probstj03/ARC-Play/hardware/3D-Druck/tft-lcd-2-4-inch-ili9341-touch-320x240-1.snapshot.15/2.jpg

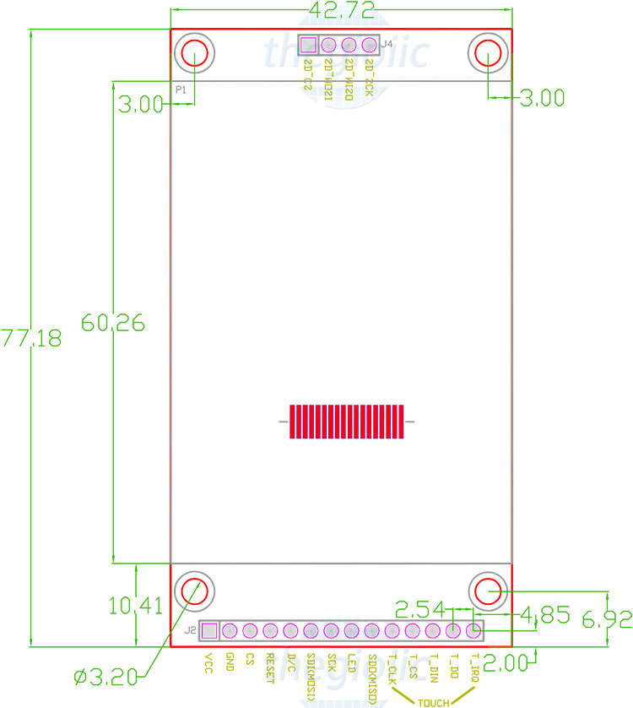
hardware/3D-Druck/tft-lcd-2-4-inch-ili9341-touch-320x240-1.snapshot.15/2.jpg
