probstj03/ARC-Play/hardware/3D-Druck/ARC_Play.FCStd

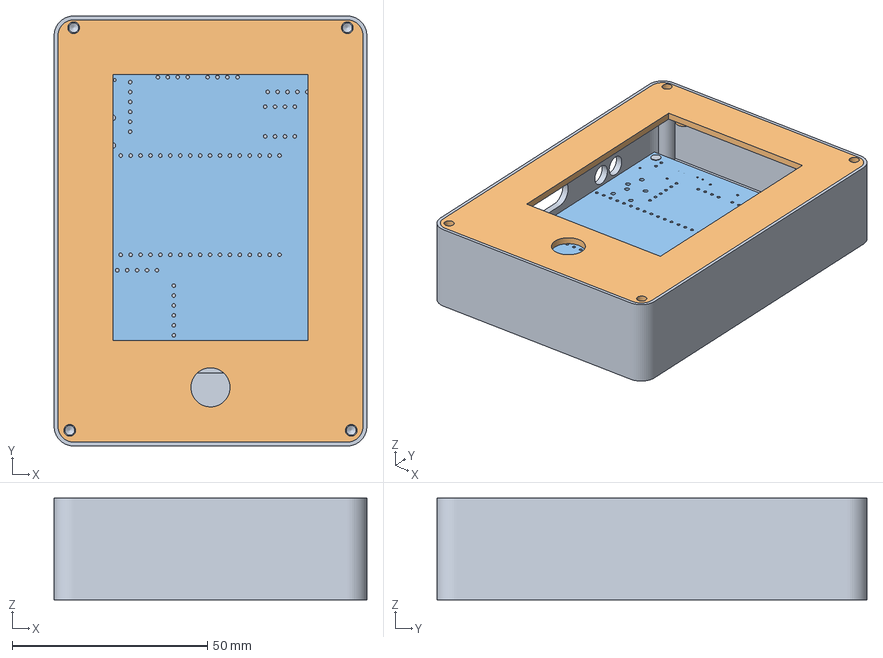
[picture p8: CAD file, 2026-10-11]
hardware/3D-Druck/ARC_Play.FCStd
80.0 x 110.0 x 26.0 mm
Korpus
Deckel
ARC_AP
