probstj03/ARC-Play/hardware/3D-Druck/tft-lcd-2-4-inch-ili9341-touch-320x240-1.snapshot.15/TFT LCD 2.4 inch ILI9341 touch.step

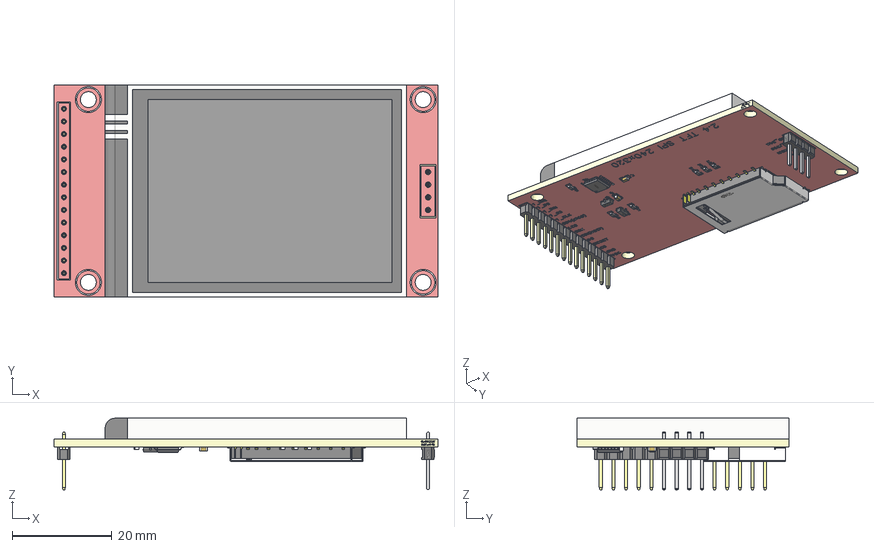
[picture p9: CAD file, 2026-10-11]
hardware/3D-Druck/tft-lcd-2-4-inch-ili9341-touch-320x240-1.snapshot.15/TFT LCD 2.4 inch ILI9341 touch.step
77.2 x 42.7 x 14.4 mm
Board~HwOR
TopSilkscreen~HwOR
BottomSilkscreen~HwOR
R0603~R0603~HwOR x 6
C0603~C0603_L1.6-W0.8-H0.8~HwOR x 2
HDR-TH_4P-P2.54-V-M~HDR-TH_4P-P2.54-M-LI-1X4P~HwOR
CONN-TH_PZ254V-11-14P~CONN-TH_PZ254V-11-14P~HwOR
SOT-23-3_L2.9-W1.3-P1.90-LS2.4-BR~SOT-23-3P_L2.9-W1.3-H1.0-LS2.4-P0.9 5~HwOR x 2
SD-CARD-SMD_SD-CARD-11P~SD-CARD-SMD_SD-CARD-11P~HwOR
TSSOP-16_L5.0-W4.4-P0.65-LS6.4-BL~TSSOP-16_L5.0-W4.4-H1.0-LS6.4-P0.65 ~HwOR
text
