probstj03/ARC-Play/hardware/ARC_Playback.1/LIB_ESP32-S3-DevKitC-1-N32R16V/ESP32-S3-DevKitC-1-N32R16V/3D/ESP32-S3-DevKitC-1-N32R16V.stp

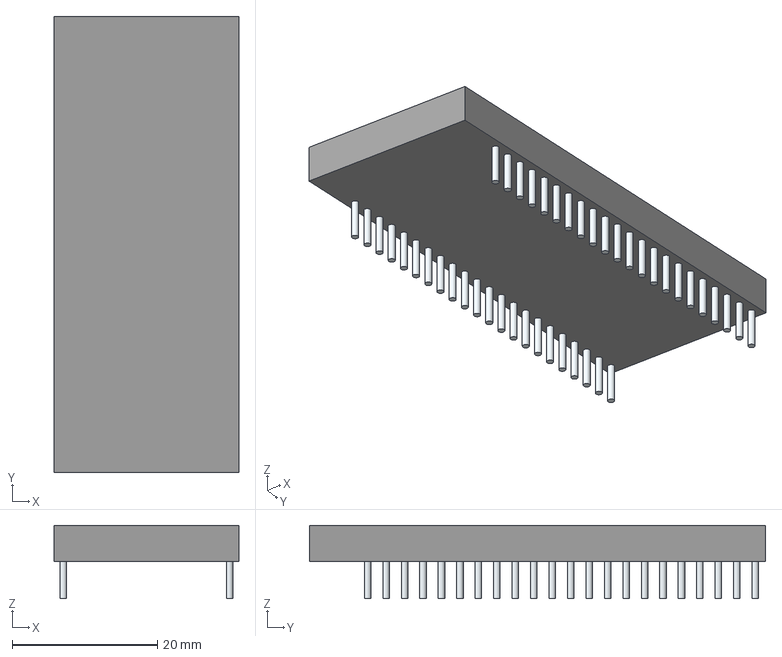
[picture p10: CAD file, 2026-10-11]
hardware/ARC_Playback.1/LIB_ESP32-S3-DevKitC-1-N32R16V/ESP32-S3-DevKitC-1-N32R16V/3D/ESP32-S3-DevKitC-1-N32R16V.stp
25.4 x 62.7 x 10.1 mm
Leads
