probstj03/ARC-Play/hardware/3D-Druck/ARC_Play_Deckel.stl

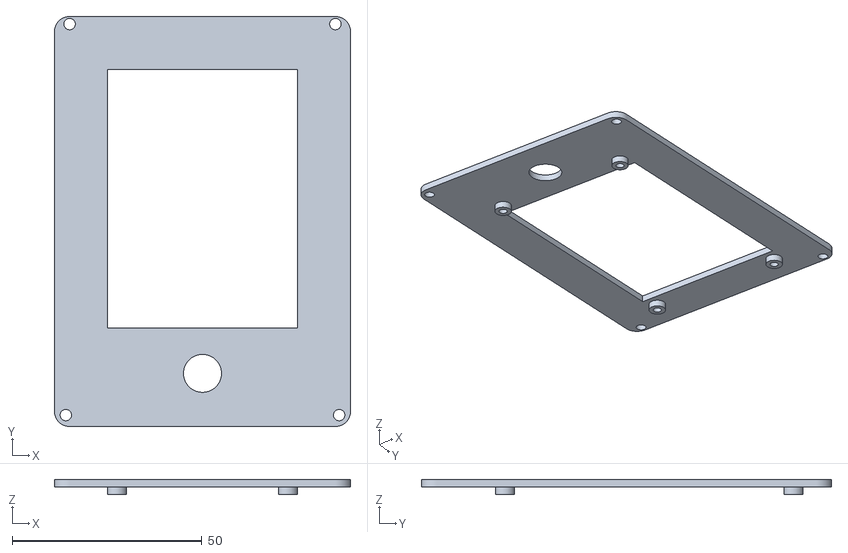
[picture p11: CAD file, 2026-10-11]
hardware/3D-Druck/ARC_Play_Deckel.stl
78.0 x 108.0 x 4.00
