probstj03/ARC-Play/hardware/3D-Druck/ARC_Play_Korpus.stl

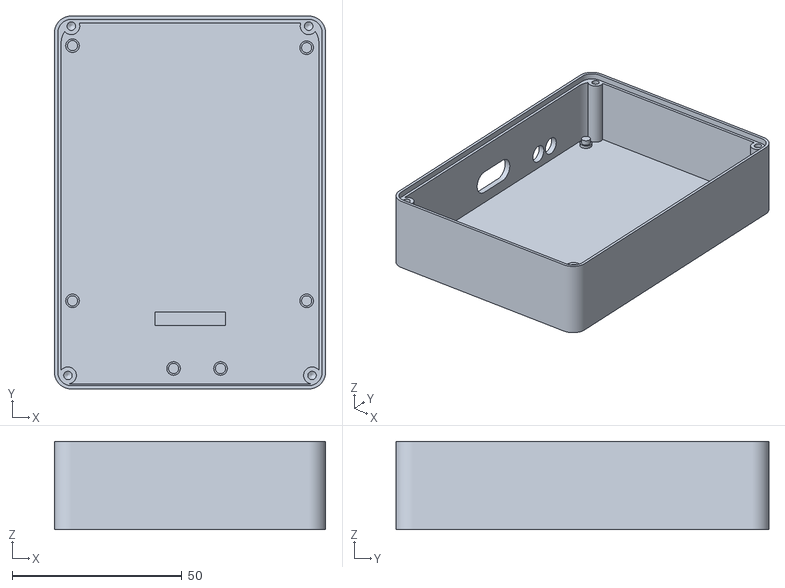
[picture p12: CAD file, 2026-10-11]
hardware/3D-Druck/ARC_Play_Korpus.stl
80.0 x 110.0 x 26.0
