probstj03/ARC-Play/(list of files, cad)

Other CAD files:
hardware/ARC_Playback.1/LIB_ESP32-S3-DevKitC-1-N32R16V/ESP32-S3-DevKitC-1-N32R16V/Allegro/esp32s3devkitc1n32r16v.psm
hardware/ARC_Playback.1/LIB_ESP32-S3-DevKitC-1-N32R16V/ESP32-S3-DevKitC-1-N32R16V/DEHDL/esp32_s3_devkitc_1_n32r16v/chips/chips.prt
