probstj03/ARC-Play/hardware/ARC_Playback.1/ARC_AP_Druck.pdf

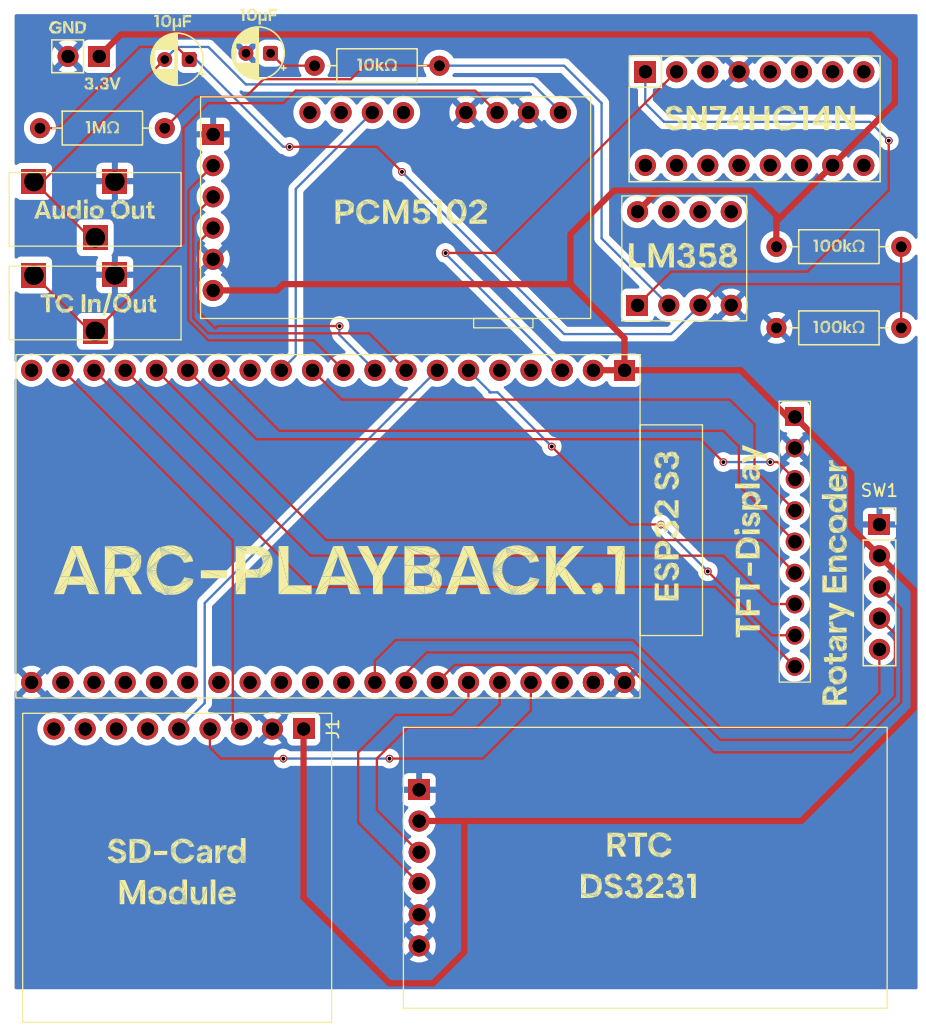
[picture p13: page 1]
