probstj03/ARC-Play/(list of files, drawings)

Other design files:
hardware/ARC_Playback.1/LIB_ESP32-S3-DevKitC-1-N32R16V/ESP32-S3-DevKitC-1-N32R16V/Altium/ESP32-S3-DevKitC-1-N32R16V.SchLib
hardware/ARC_Playback.1/LIB_ESP32-S3-DevKitC-1-N32R16V/ESP32-S3-DevKitC-1-N32R16V/Altium/ESP32S3DevKitC1N32R16V.PcbLib
