probstj03/ARC-Play/hardware/ARC_Playback.1/ARC_AP.kicad_pcb

## KiCad design hardware/ARC_Playback.1/ARC_AP.kicad_pcb (2026-10-11)

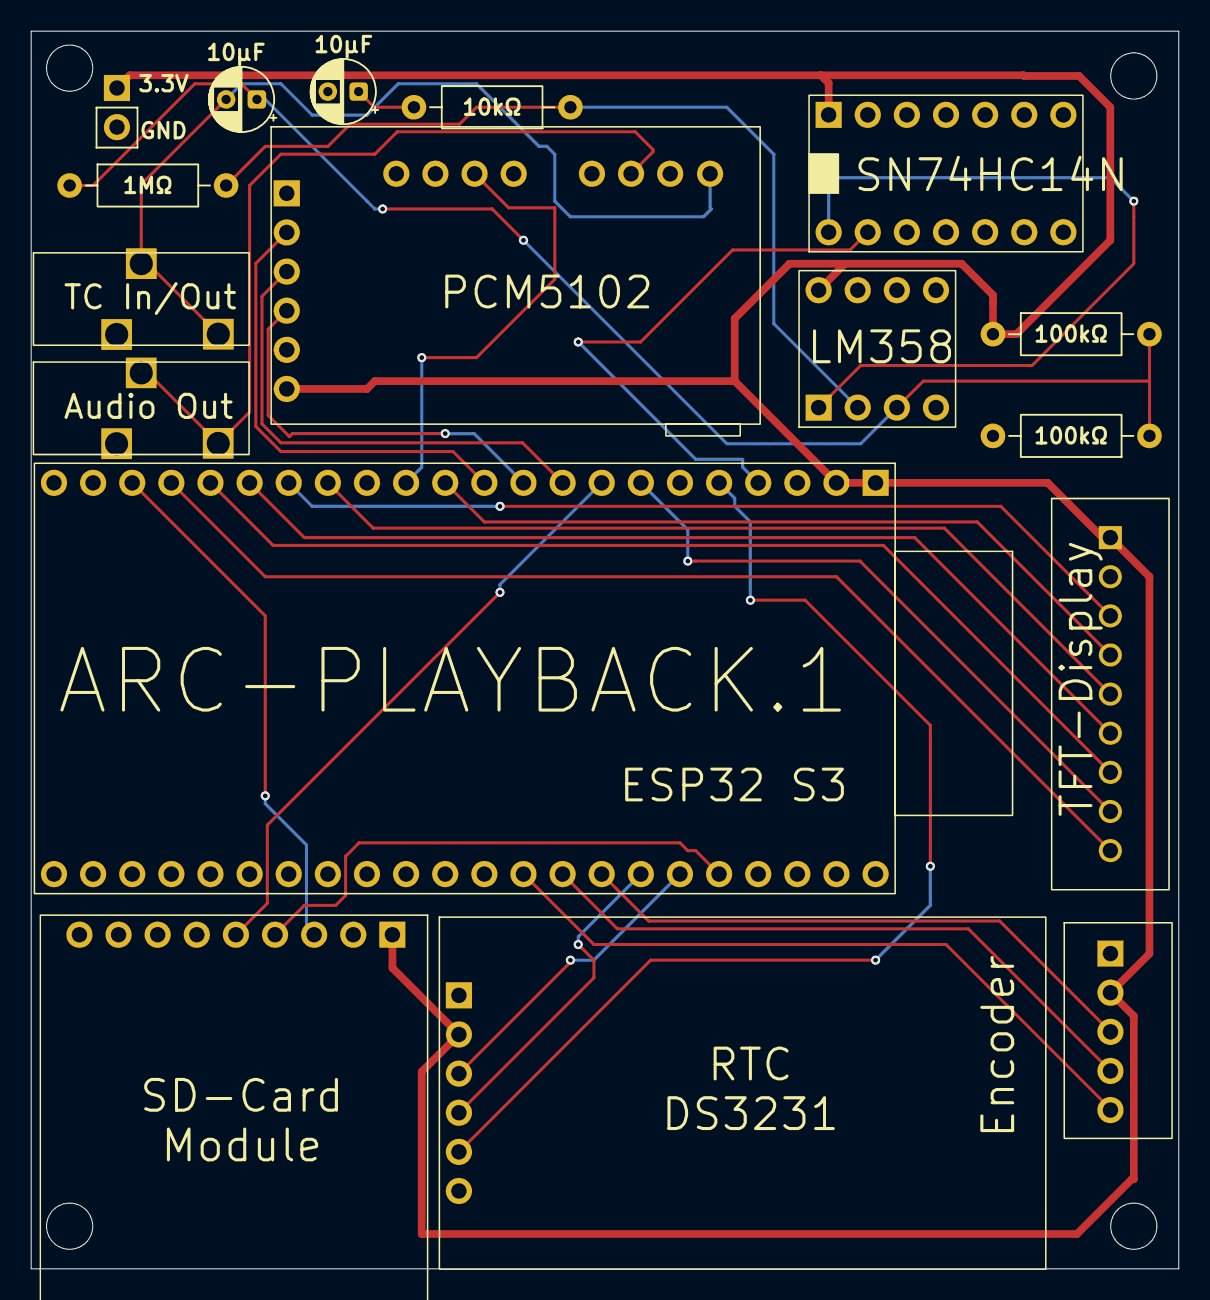
[picture p14: board ARC_AP.kicad_pcb from above]

Board: 2 copper layers, 74.5 x 80.3 mm, 17 parts (0 on the bottom side), 28 nets.

Parts:
C1, C2: 10nF; CP_Radial_D4.0mm_P2.00mm
J1: Micro_SD_Card_Det1; PinHeader_1x09_P2.54mm_Vertical
J2: TC In/Out; Klinkenbuchse
J3: Playback Out; Klinkenbuchse
J4: Power Supply; PinSocket_1x02_P2.54mm_Vertical
R1, R2: 100kOhm; R_Axial_DIN0207_L6.3mm_D2.5mm_P10.16mm_Horizontal
R3: 1MOhm; R_Axial_DIN0207_L6.3mm_D2.5mm_P10.16mm_Horizontal
R4: 10kOhm; R_Axial_DIN0207_L6.3mm_D2.5mm_P10.16mm_Horizontal
SW1: RotaryEncoder_Switch; PinSocket_1x05_P2.54mm_Vertical
U1: ESP32-S3-DevKitC-1-N32R16V; ESP32S3
U2: DS3231M; PinSocket_1x06_P2.54mm_Vertical
U3: LM358
U4: CR2013-MI2120
U6: SN74HC14N
U7: PCM5102A; PCM5102

Connections:
+3.3V: J1.1 (3V), J4.1, R1.1, SW1.2 (VCC), U1.J111 (3V3_1), U1.J112 (3V3_2), U2.2 (VCC), U3.8 (V+), U4.1 (VCC), U6.14 (VCC), U7.1 (VIN)
GND: C1.2, J1.2 (GND), J2.3, J3.3, J4.2, R2.2, SW1.1 (GND), U1.J132 (G_1), U1.J311 (G_2), U1.J331 (G_3), U1.J332 (G_4), U2.1 (GND), U3.4 (V-), U4.2 (GND), U6.7 (GND), U7.2 (GND), U7.6 (SCK), U7.11 (GND), U7.13 (GND)
unnamed: C1.1, R4.2
unnamed: J1.3 (CLK), U1.J130 (14)
unnamed: J1.5 (CMD), U1.J118 (15)
unnamed: J1.4 (D0), U1.J315 (2)
unnamed: SW1.5 (CLK), U1.J320 (38)
unnamed: SW1.4 (DT), U1.J319 (39)
unnamed: SW1.3 (SW), U1.J318 (40)
unnamed: U1.J123 (3), U7.9 (XSMT_3)
unnamed: U1.J114 (4), U6.2 (1Y)
unnamed: U1.J117 (7), U4.8 (LED)
unnamed: U1.J122 (8), U4.4 (RESET)
unnamed: U1.J125 (9), U4.5 (D/~C)
unnamed: U1.J126 (10), U4.3 (~CS)
unnamed: U1.J127 (11), U4.6 (MOSI)
unnamed: U1.J128 (12), U4.7 (SCK)
unnamed: U1.J129 (13), U4.9 (MISO)
unnamed: U1.J119 (16), U7.4 (DIN)
unnamed: U1.J120 (17), U7.3 (LRCK)
unnamed: U1.J121 (18), U7.5 (BCK)
unnamed: U1.J317 (41), U2.4 (SCL)
unnamed: U1.J316 (42), U2.3 (SDA)
unnamed: C2.1, R1.2, R2.1, R3.1, U3.3 (+)
unnamed: R3.2, R4.1, U3.2 (-)
unnamed: U3.1, U6.1 (1A)
unnamed: C2.2, J2.1, J2.2, U7.14 (OUTL)
unnamed: J3.1, J3.2, U7.12 (OUTR)
