probstj03/ARC-Play/(commit log)

2026-10-11 Play-Firmware 2.0.0-dev auf ARC-Core
    - Uhr, phasengeregelter LTC, Jam Sync mit Prüfphase, Netzwerk und Ereignisse aus ARC-Core
    - play_audio: sample-genauer, geplanter Playback-Start (Song + Vorzähler + LTC auf demselben Sample),
    Stopp exakt am Shot-Ende, Take-Ereignis mit µs-Zeit
    - play_ui: TFT + Encoder (Bedienung wie bisher, plus Jam-Prüfung und Kabel-Bestätigung)
    - play_link: Shot, Song-Info, Upload, Lautstärke; Legacy-Nachrichten für das aktuelle ARC-Studio
    - WLAN-Zugangsdaten nur noch lokal in secrets.h
2026-10-12 Offline-Projekte: Shotliste auf den Geräten, Logs nachträglich abholen
    - ARC-Core: arc_project (project_put -> /project.json, log_pull/log_chunk/log_ack),
    hello meldet projectCode und lastEventId
    - Geräte: Shot-Auswahl ohne ARC-Studio aus dem Offline-Projekt, Take-Nummer aus dem eigenen Log
    - ARC-Studio: 'Projekt auf Geräte', automatisches Abholen und Einsortieren offline aufgezeichneter
    Ereignisse (Duplikaterkennung, Stand je Gerät in deviceLogs); Geräte verbinden erst nach dem Laden des Projekts
